CarsonDPope/Active-Noise-Control-With-Wall-Transmission-Detection/Software/Arduino-NANO-33-IoT/readme.md

This is for Arduino NANO 33 Iot but should be compatible with most Arduino devices that use BLE.

To use, download the Arduino IDE, paste this code into the IDE, and use a USB connection to upload this to the Arduino device while defining the board you are using.
