CarsonDPope/Active-Noise-Control-With-Wall-Transmission-Detection/Documentation/Electrical/Schematics/Input_Error_PCB.png

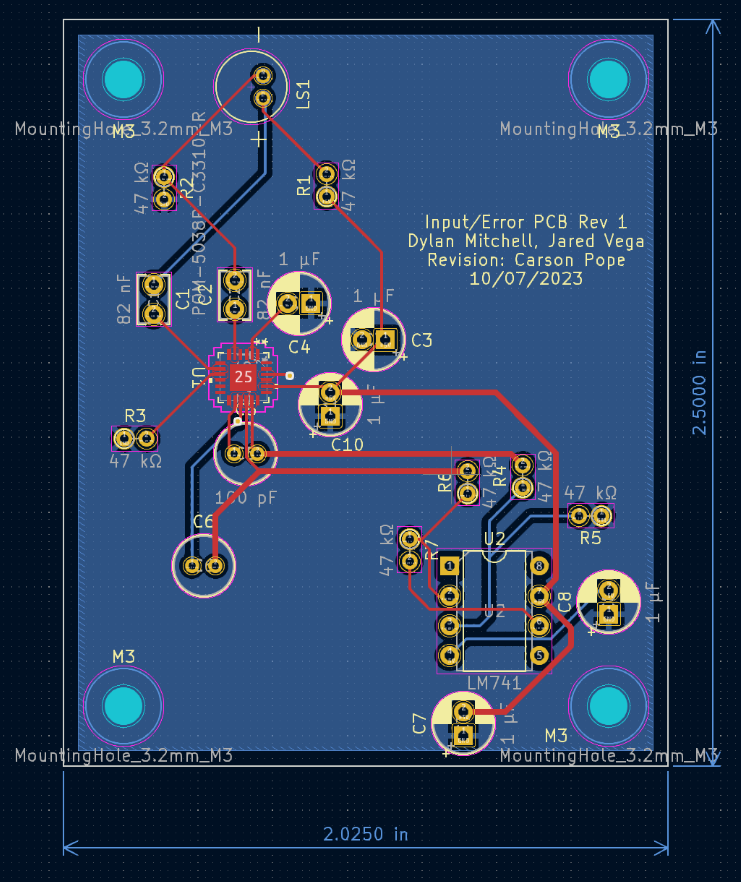
Documentation/Electrical/Schematics/Input_Error_PCB.png
