CarsonDPope/Active-Noise-Control-With-Wall-Transmission-Detection/Documentation/Electrical/Schematics/Output_Subsystem.png

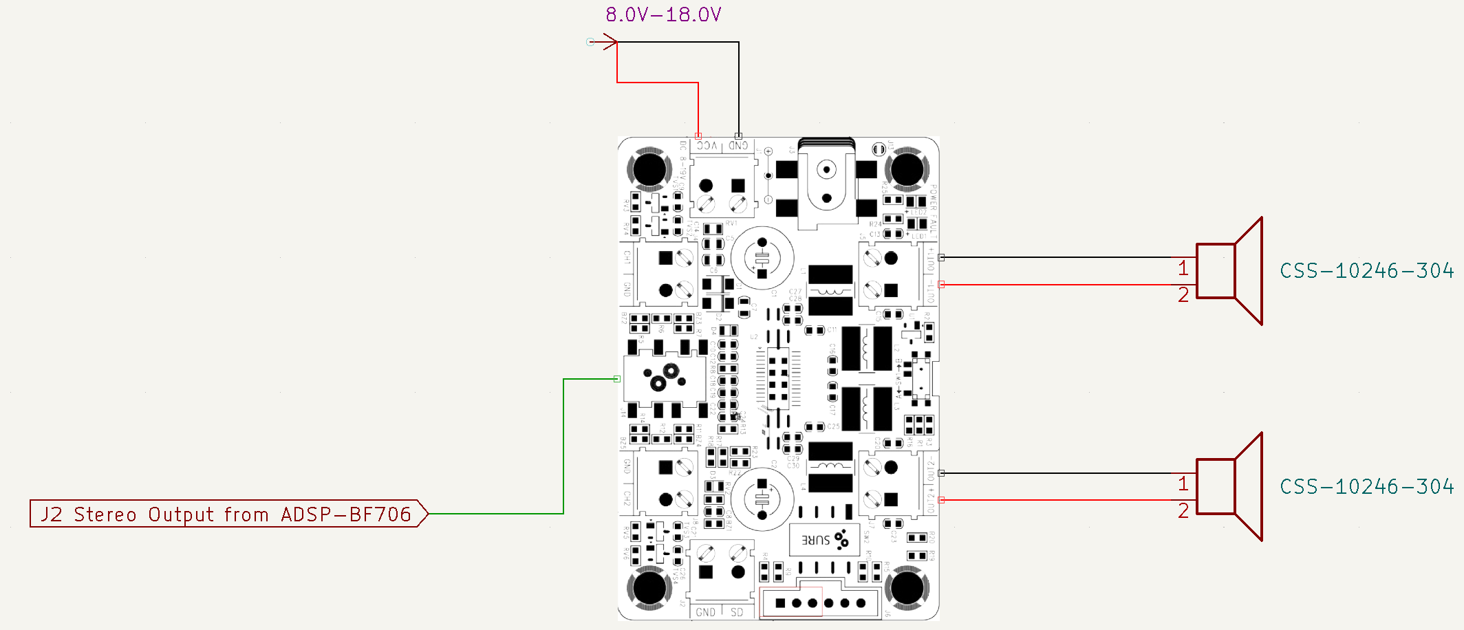
Documentation/Electrical/Schematics/Output_Subsystem.png
