CarsonDPope/Active-Noise-Control-With-Wall-Transmission-Detection/Documentation/Images/Output/CSS-10246-304_Response.png

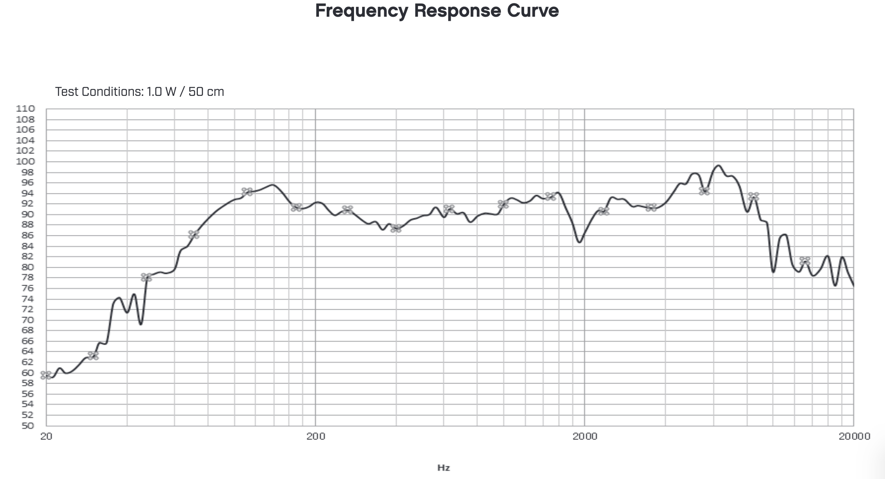
Documentation/Images/Output/CSS-10246-304_Response.png
