CarsonDPope/Active-Noise-Control-With-Wall-Transmission-Detection/Documentation/Images/Output/Equivalent_Speaker_Response.png

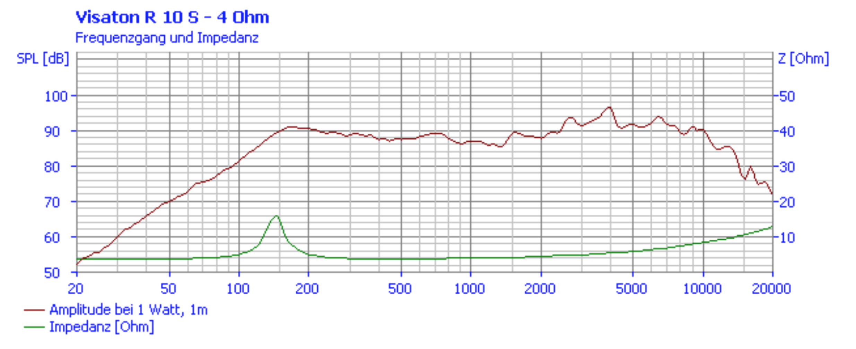
Documentation/Images/Output/Equivalent_Speaker_Response.png
