CarsonDPope/Active-Noise-Control-With-Wall-Transmission-Detection/Documentation/Images/Output/Frequency_Response.png

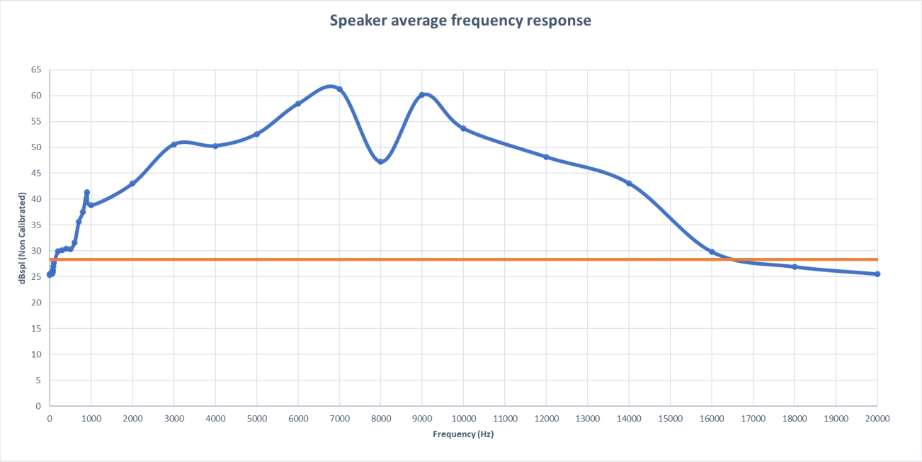
Documentation/Images/Output/Frequency_Response.png
