CarsonDPope/Active-Noise-Control-With-Wall-Transmission-Detection/Documentation/Images/Output/Output_Flowchart.png

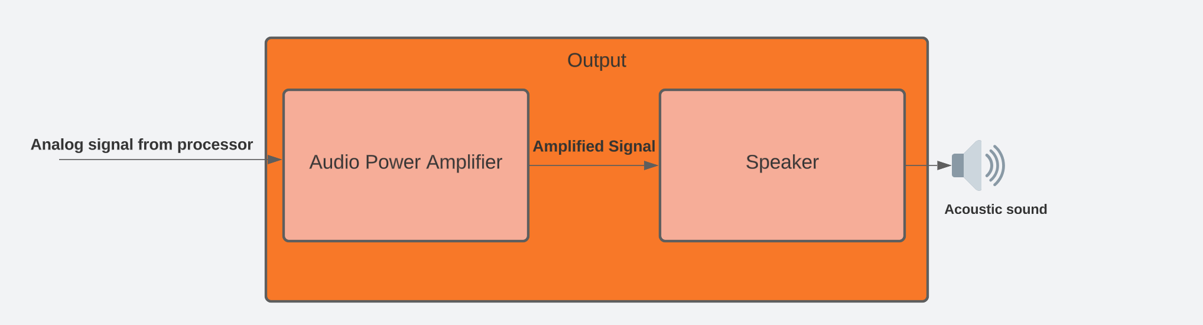
Documentation/Images/Output/Output_Flowchart.png
