CarsonDPope/Active-Noise-Control-With-Wall-Transmission-Detection/Documentation/Images/Output/Radiation_Pattern.png

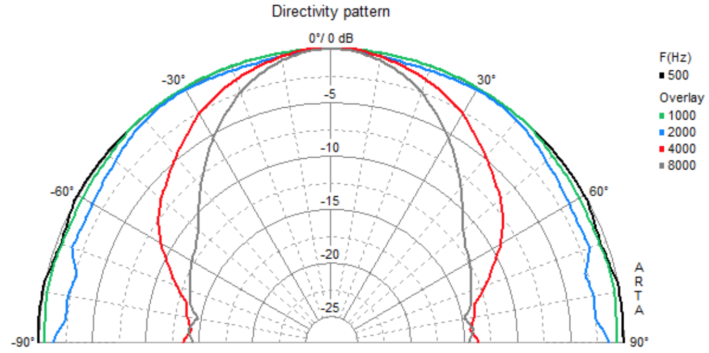
Documentation/Images/Output/Radiation_Pattern.png
