CarsonDPope/Active-Noise-Control-With-Wall-Transmission-Detection/Documentation/FinalBOM.pdf

Component | Quantity | Price
Main Processor
Arduino Uno R4 | 1 | $27.49
Arduino Stackable Header Kit | 2 | $3.50
Blackfin Processor | 1 | $88.31
Input and Error
Electret Microphone | 4 | $6.24
Op Amp (Set of 8) | 1 | $8.54
Pre Amp | 4 | 12.72
Output
Audio Amplifier Board | 2 | $16.98
4 OHM 10 W Speaker | 4 | $15.37
Power
36 W AC Adaptor | 1 | $15.99
2-Pack Buck Converter | 1 | $5.49
2"x4" Protoboard | 1 | $4.59
Passives
82 nF Capacitor | 4 | $0.43
1 µF Capacitor | 10 | $0.12
0.1 µF Capacitor | 4 | $0.23
MicroUSB type B | 1 | $6.13
3.28 Ft 3.5mm Aux Cord | 2 | $4.99
Audio Jack to Pinout Adapter | 1 | $7.99
Total | | $225.11
