CarsonDPope/Active-Noise-Control-With-Wall-Transmission-Detection/Documentation/3D Models/Shelf.stl

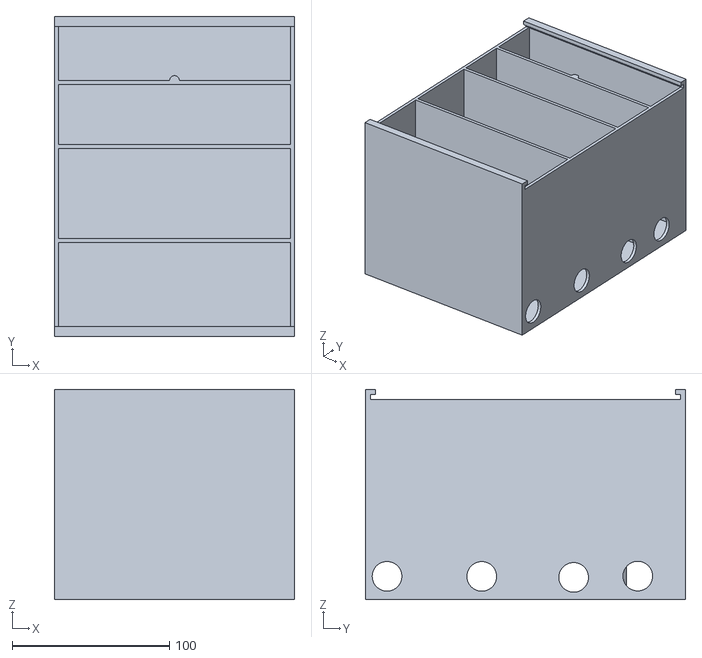
[picture p20: CAD file, 2023-12-01]
Documentation/3D Models/Shelf.stl
152.4 x 203.2 x 133.3
