CarsonDPope/Active-Noise-Control-With-Wall-Transmission-Detection/Documentation/3D Models/Scene.stl

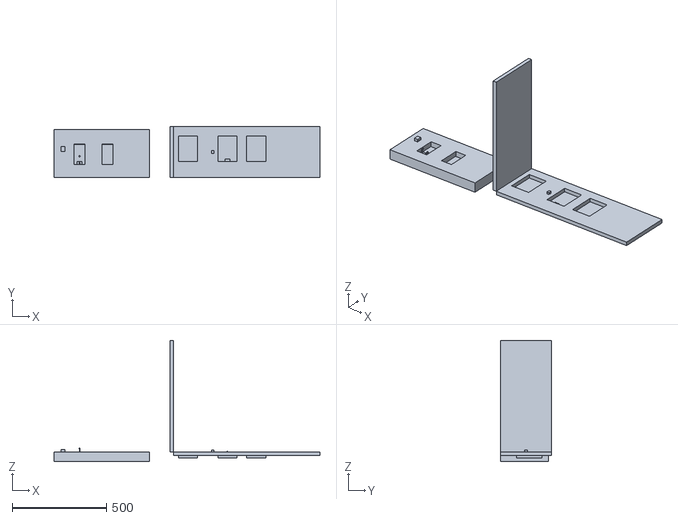
[picture p21: CAD file, 2023-12-01]
Documentation/3D Models/Scene.stl
1413.8 x 270.8 x 643.4
