CarsonDPope/Active-Noise-Control-With-Wall-Transmission-Detection/Documentation/3D Models/Sliding_Door.stl

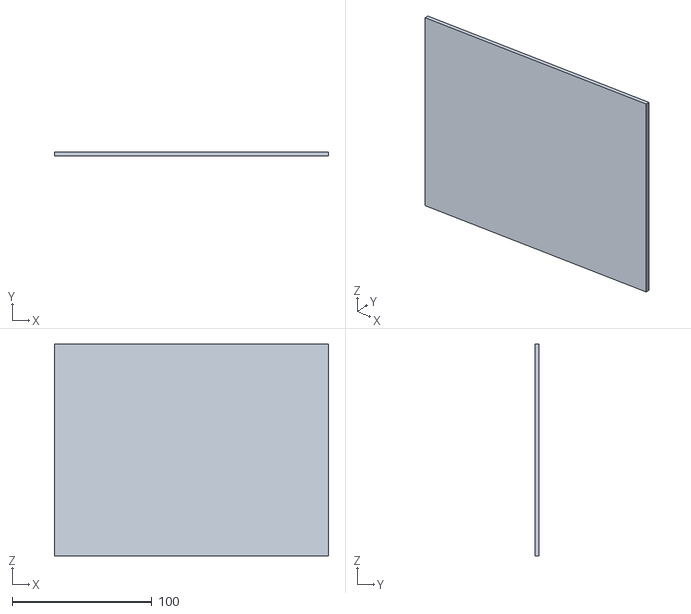
[picture p22: CAD file, 2023-12-01]
Documentation/3D Models/Sliding_Door.stl
196.2 x 3.05 x 151.8
