CarsonDPope/Active-Noise-Control-With-Wall-Transmission-Detection/(list of files, cad)

Other CAD files:
Documentation/3D Models/Scene.ipt
Documentation/3D Models/Shelf.ipt
Documentation/3D Models/Sliding_Door.ipt
